Jacquot-SFE/Teensy-synth-platform/research-and-design/proto-8_vanity.jpg

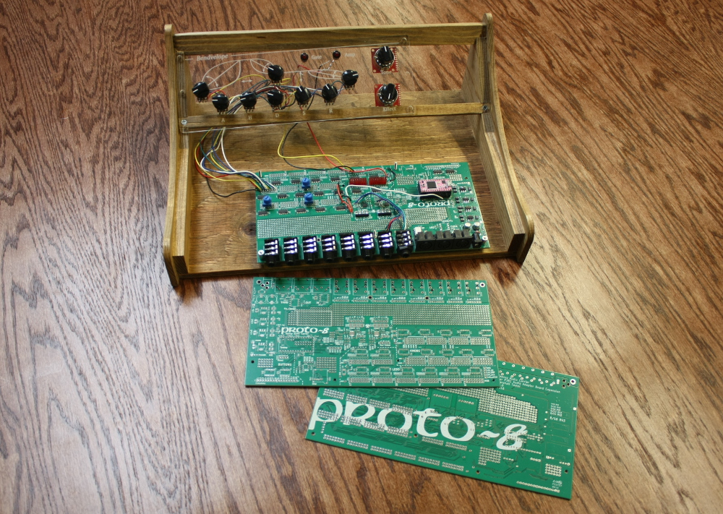
research-and-design/proto-8_vanity.jpg
