Jacquot-SFE/Teensy-synth-platform/presentation/slides/images/arduino.png

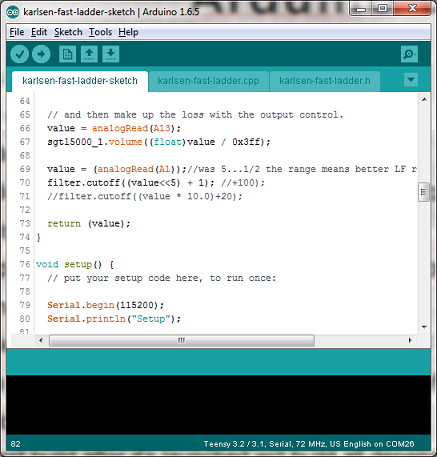
presentation/slides/images/arduino.png
