Jacquot-SFE/Teensy-synth-platform/specs/notes.md

# Notes

**Proposed directory structure**

* documentation -- final documentation of the fully-spec'd product
* hardware -- eagle design files
* libraries -- eagle custom part libraries
* mechanical -- max panel size, possible configurations, case
* research-and-design
 * audio-codec -- codec options and requirements
 * audio-io -- datasheets and audio level driver, buffer calculations, solutions matrix
 * midi -- probably not necessary
 * panel-matrixing -- knob, switch, and LED options
 * power-supply -- requirements, solution matrix, power budget
* specs -- Contains project organization stuff
