Jacquot-SFE/Teensy-synth-platform/research-and-design/power-supply/pmic-options/questionts-to-answer.md

# Questions to answer regarding power supplies

* Do we need a negative supply?
 * Flyback a tapped transformer and regulate from there?
 * Use dual output sepics?
 * Use two single sepics?
* Do we want the circuit to be isolated?
* Do we want integrated fets?
* How much spare current capibility do we provide?

# Questions we've answered (sort of)

* the 5v supply might be on the order of 400mA
