Jacquot-SFE/Teensy-synth-platform/research-and-design/power-supply/power-budget.ods

Knobs
Notes | Current | Multiplier | SubSubtotal
3.3v/10k | 0.00033 | 64 | 0.02112
Mux | 0.00008 | 10 | 0.00080
 |  |  | SubTotal: | 0.022
Switches
Notes | Current | Multiplier | SubSubtotal
3.3v/10k | 0.00033 | 64 | 0.02112
 |  |  | SubTotal: | 0.021
LEDs
Notes | Current | Multiplier | SubSubtotal
LED bias | 0.00200 | 64 | 0.12800
 |  |  | SubTotal: | 0.128
Teensy
Notes | Current | Multiplier | SubSubtotal
Max 150 | 0.15000 | 1 | 0.15000
 |  |  | SubTotal: | 0.150
Midi
Notes | Current | Multiplier | SubSubtotal
2 loops | 0.00500 | 2 | 0.01000
 |  |  | SubTotal: | 0.010
Midi
Notes | Current | Multiplier | SubSubtotal
4 shorted outs | 0.00500 | 4 | 0.02000
 |  |  | SubTotal: | 0.020
 |  |  | Grand Total: | 0.351 | Amps
