Jacquot-SFE/Teensy-synth-platform/presentation/slides/images/bkdrp.JPG

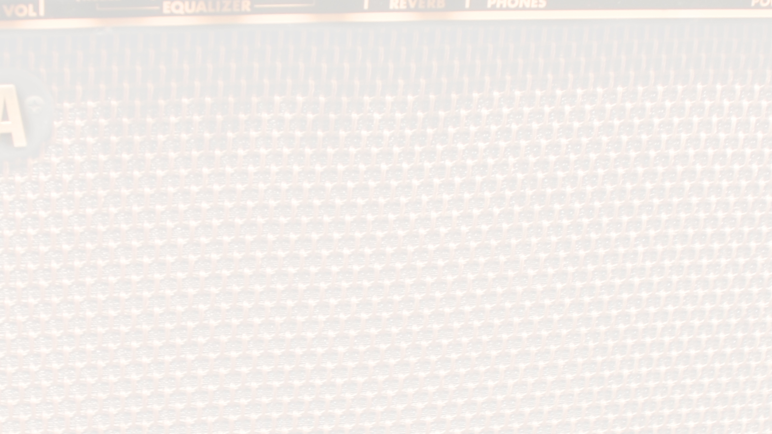
presentation/slides/images/bkdrp.JPG
