Jacquot-SFE/Teensy-synth-platform/presentation/slides/images/notedoor.jpg

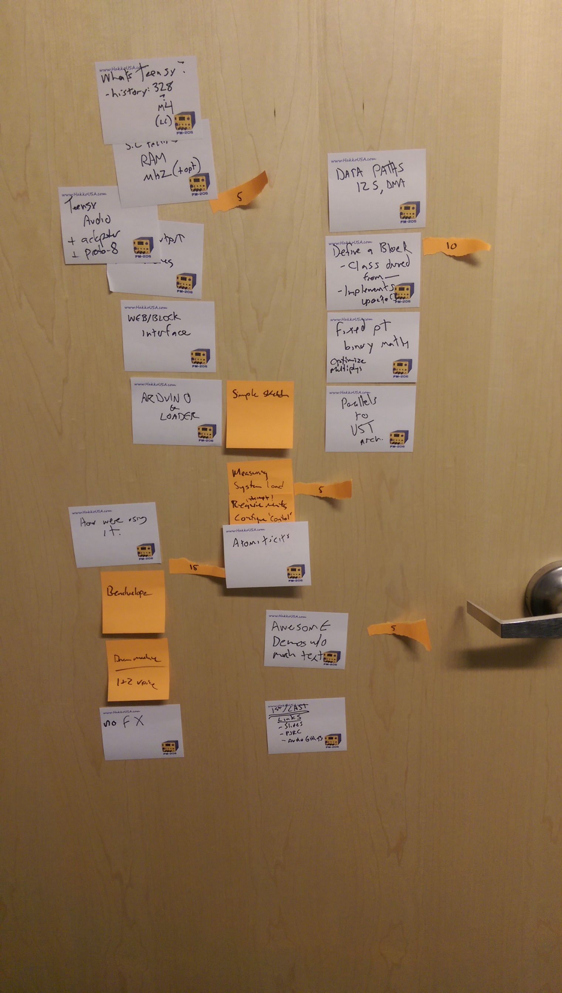
presentation/slides/images/notedoor.jpg
