Jacquot-SFE/Teensy-synth-platform/research-and-design/power-supply/pmic-options/pmic-options.ods

Manufacturer | Part number | Vin | Price | Notes
TI | tl5001a-q1 | 3.6 to 40 | $0.85 @ 1000 | External switch, boost, buck, invert
TI | lm25011 | 6 to 42 | $0.95 @ 1000 | Buck only, 2A, stepoko
TI | sg2524 | 8 to 40 | $0.36 @ 1000 | Multipurpose, flyback, super cheap
LT | LT8471 | 6 to 50 | $5.00 @ 2500 | Dual output 2A, integrated switches, probably wrong pricing
LT | LT8582 | 5 to 22 | $5.00 @ 2500 | Dual output 2A, integrated switches, probably wrong pricing
Maxim | MAX13256 | 36V | $3.00 @ 2500 | No regulation, pumps transformer with H bridge
ST | UC284XB/UC384XB | 30V | $0.25 to $0.60 | UVLO from 8.5 to 16 by part no. Totem output for NMOS drive
