Jacquot-SFE/Teensy-synth-platform/research-and-design/panel-matrixing/analog-mux-options.ods

Sheet: Matrixing options
Desire 64 knobs |  |  |  |  |  |  | Uses 3k quantity pricing from digikey
Mux depth | Level 0 | Level 1 | Level 2 | Level 3 | Ain consumed | Muxes used | Price/mux | total
2 | 32 | 16 | 8 | 4 | 4 | 60 | $0.30 | $18.00
4 | 16 | 4 |  |  | 4 | 20 | $0.23 | $4.60
8 | 8 | 1 |  |  | 1 | 9 | $0.63 | $5.67
16 | 4 |  |  |  | 4 | 4 | $3.50 | $14.00
32 | 2 |  |  |  | 2 | 2 | $4.30 | $8.60
64 | 1 |  |  |  | 1 | 1
M74HC4052RM13TR |  | Part 11141 | $0.09
 | Price | Quantity | Sub
M74HC4052RM13TR | $0.09 | 10 | $0.90
 |  |  | $0.90

Sheet: 2x8x2x2
CTRL |  |  |  | Analog inputs
Level 0 |  | Level 1 |  | A0 | A1 | A2 | A3
0 | 0 | 0 | 0 | K00 | K16 | K32 | K48
0 | 1 | 0 | 0 | K01 | K17 | K33 | K49
1 | 0 | 0 | 0 | K02 | K18 | K34 | K50
1 | 1 | 0 | 0 | K03 | K19 | K35 | K51
0 | 0 | 0 | 1 | K04 | K20 | K36 | K52
0 | 1 | 0 | 1 | K05 | K21 | K37 | K53
1 | 0 | 0 | 1 | K06 | K22 | K38 | K54
1 | 1 | 0 | 1 | K07 | K23 | K39 | K55
0 | 0 | 1 | 0 | K08 | K24 | K40 | K56
0 | 1 | 1 | 0 | K09 | K25 | K41 | K57
1 | 0 | 1 | 0 | K10 | K26 | K42 | K58
1 | 1 | 1 | 0 | K11 | K27 | K43 | K59
0 | 0 | 1 | 1 | K12 | K28 | K44 | K60
0 | 1 | 1 | 1 | K13 | K29 | K45 | K61
1 | 0 | 1 | 1 | K14 | K30 | K46 | K62
1 | 1 | 1 | 1 | K15 | K31 | K47 | K63

Sheet: decode-summer
Comment
 | Price | Quantity | Sub
LM358 | $0.08 | 4 | $0.32
Res | $0.01 | 80 | $0.80
BJT | $0.01 | 16 | $0.16
 |  |  | $1.28

Sheet: Control
Bank Select | Pole Select | A0 | A1 | A2 | A3
0x0 | 0x0 | K00 | K16 | K32 | K48
0x0 | 0x1 | K01 | K17 | K33 | K49
0x0 | 0x2 | K02 | K18 | K34 | K50
0x0 | 0x3 | K03 | K19 | K35 | K51
0x1 | 0x0 | K04 | K20 | K36 | K52
0x1 | 0x1 | K05 | K21 | K37 | K53
0x1 | 0x2 | K06 | K22 | K38 | K54
0x1 | 0x3 | K07 | K23 | K39 | K55
0x2 | 0x0 | K08 | K24 | K40 | K56
0x2 | 0x1 | K09 | K25 | K41 | K57
0x2 | 0x2 | K10 | K26 | K42 | K58
0x2 | 0x3 | K11 | K27 | K43 | K59
0x3 | 0x0 | K12 | K28 | K44 | K60
0x3 | 0x1 | K13 | K29 | K45 | K61
0x3 | 0x2 | K14 | K30 | K46 | K62
0x3 | 0x3 | K15 | K31 | K47 | K63
