Jacquot-SFE/Teensy-synth-platform/(list of files, cad)

Other CAD files:
milling/CheekyElevations/CheekyElevations.FCStd
milling/OpenFacedCheeks/OpenFacedCheeks.FCStd
