Jacquot-SFE/Teensy-synth-platform/research-and-design/power-supply/coil-simulations/flyback.asc

C1: cap; 10µF
C2: cap; 0.001µF
D1: diode
L1: ind2; 10µ
L2: ind2; 10µ
M1: nmos; BSC12DN20NS3
R1: res; 100
R2: res; 1k
R3: res; 1k
R4: res; 1Meg
U2: LT1720
V1: voltage; PULSE(0 5 0 3.99u 0.01u 0 0 1000)
V2: voltage; 15
V3: voltage; 5
V4: voltage; 0
Named nets: 0
.tran 0 .001 0 100n
K L1 L2 1
.lib opamp.sub
