Jacquot-SFE/Teensy-synth-platform/research-and-design/power-supply/coil-simulations/basic-xfmr.asc

L1: ind2; 10µ
L2: ind2; 10µ
M1: nmos; BSC12DN20NS3
R1: res; 50
V1: voltage; PULSE(0 5 .000004 0 0 .000001 .000004 40)
V2: voltage; 15
Named nets: 0
.tran .0002
K L1 L2 1
