Jacquot-SFE/Teensy-synth-platform/research-and-design/power-supply/coil-simulations/LTC1871_sepic.asc

C1: cap; 6800p
C2: cap; 50p
C3: polcap; 4.7µ; Rser=0.05
C4: cap; 33µ; Rser=0.002
C5: cap; 10µ; Rser=0.002
C6: polcap; 150µ; Rser=.01
C7: cap; 10µ; Rser=0.002
D1: schottky; MBR735
I1: load2; 2A; load
L1: ind2; 4.6µ; Rser=0.010
L2: ind2; 4.6µ; Rser=0.010
Q1: NMOS; Si4840DY
R1: RES; 80.6K
R2: res; 12.4K
R3: res; 110K
R4: res; 33.2K
R5: res; 133K
R6: res; 274K
U1: LTC1871
V1: VOLTAGE; 15
Named nets: 0, IN, OUT
K1 L1 L2 1
.tran 1m startup
LTC1871 - 2A SEPIC DC/DC Converter
Input: 5V-15V  Output: 12V@2A
Note:
  If the simulation model is not found please update with the "Sync Release" command from the "Tools" menu.
  It remains the customer's responsibility to verify proper and reliable operation in the actual application.
  Component substitution and printed circuit board layout may significantly affect circuit performance or reliability
  Contact your local sales representative for assistance. This circuit is distributed to customers only for use with LTC parts
  Copyright © 2006 Linear Technology Inc. All rights reserved.
