Jacquot-SFE/Teensy-synth-platform/research-and-design/power-supply/in-rush-limiter/simulation.asc

C1: cap; 1000µF
C2: cap; 4.7µF
D1: diode
M1: pmos; FDS6575
R1: res; 33
R2: res; 1MEG
R3: res; 500k
R4: res; 100
V1: voltage; PULSE(0 12 .01 0.000001 0.000001 .4 1 2)
Named nets: 0
Bulk
Load
.tran 1
