Jacquot-SFE/Teensy-synth-platform/hardware/teensy-boom-jr/teensy-boom-jr.brd

## EAGLE design hardware/teensy-boom-jr/teensy-boom-jr.brd (2016-02-10)

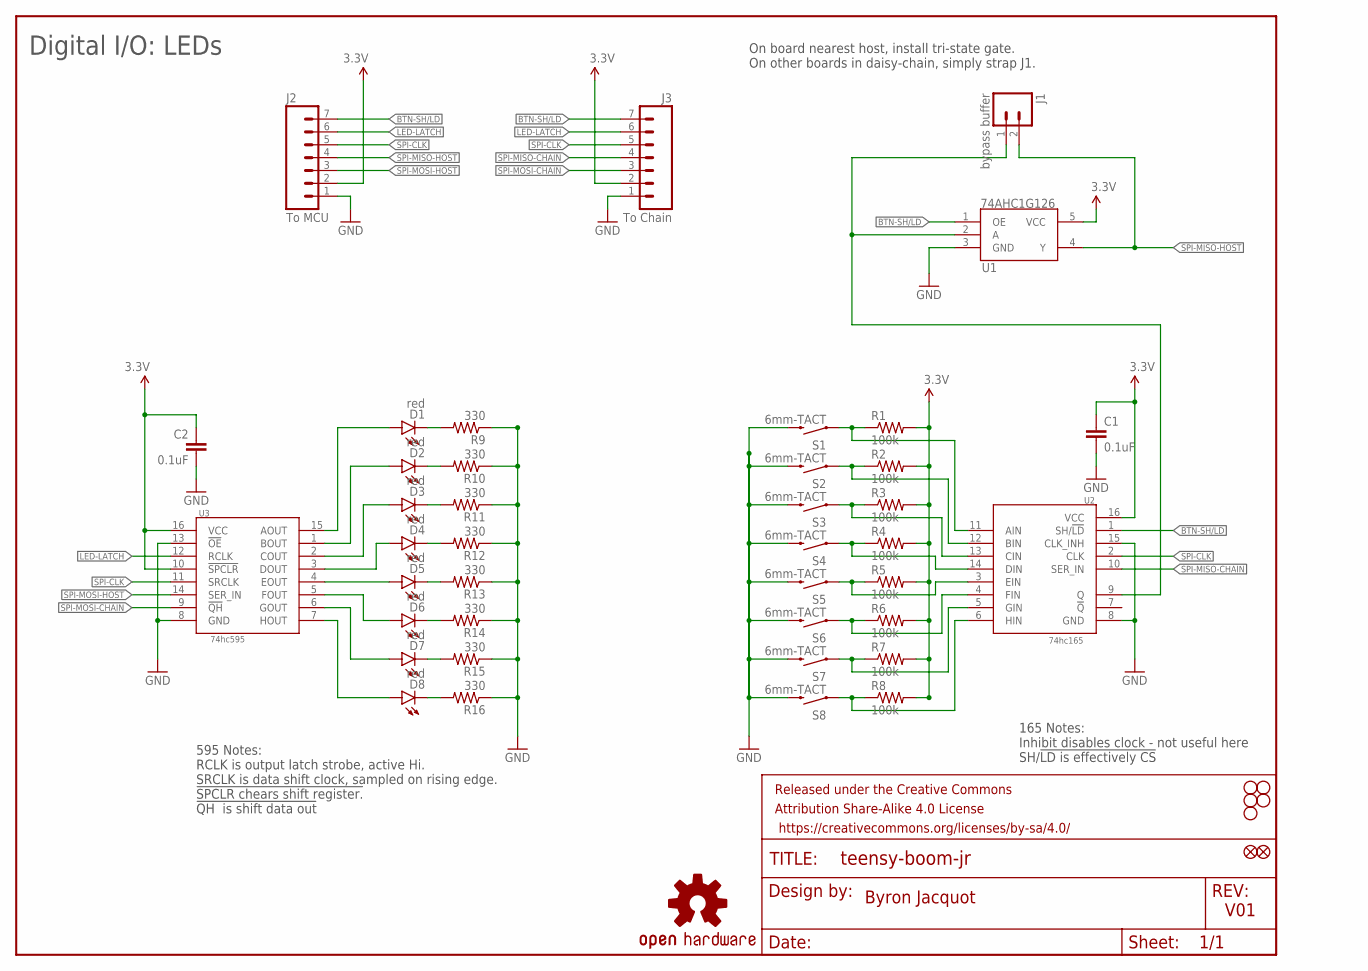
[picture p27: schematic teensy-boom-jr.sch]

Parts:
C1, C2: 0.1uF; 0603-CAP
D1, D2, D3, D4, D5, D6, D7, D8: red; LED3MM-NS
FD1, FD2: FIDUCIALUFIDUCIAL; MICRO-FIDUCIAL
FRAME1: FRAME-LETTER; CREATIVE_COMMONS
H1, H2, H3, H4, H5: STAND-OFF
J1: bypass buffer; 1X02_NO_SILK
J2: To MCU; 1X07_NO_SILK
J3: To Chain; 1X07_NO_SILK
LOGO1: OSHW-LOGOS; OSHW-LOGO-S
R1, R2, R3, R4, R5, R6, R7, R8: 100k; 0805
R9, R10, R11, R12, R13, R14, R15, R16: 330; 0603-RES
S1, S2, S3, S4, S5, S6, S7, S8: 6mm-TACT; TACTILE-PTH-12MM
U1: 74AHC1G126; SOT23-5
U2: 74hc165; SO16
U3: 74hc595; SO16

Connections:
3.3V: C1.1, C2.1, J2.2, J3.2, R1.2, R2.2, R3.2, R4.2, R5.2, R6.2, R7.2, R8.2, U1.5 (VCC), U2.16 (VCC), U3.10 (!SPCLR), U3.16 (VCC)
BTN-SH/LD: J2.7, J3.7, U1.1 (OE), U2.1 (SH/!LD)
GND: C1.2, C2.2, J2.1, J3.1, R9.1, R10.1, R11.1, R12.1, R13.1, R14.1, R15.1, R16.1, S1.3 (2), S2.3 (2), S3.3 (2), S4.3 (2), S5.3 (2), S6.3 (2), S7.3 (2), S8.3 (2), U1.3 (GND), U2.8 (GND), U2.15 (CLK_INH), U3.8 (GND), U3.13 (!OE)
LED-LATCH: J2.6, J3.6, U3.12 (RCLK)
unnamed: R1.1, S1.1, U2.11 (AIN)
unnamed: R2.1, S2.1, U2.12 (BIN)
unnamed: R3.1, S3.1, U2.13 (CIN)
unnamed: R4.1, S4.1, U2.14 (DIN)
unnamed: D8.K (C), R16.2
unnamed: R5.1, S5.1, U2.3 (EIN)
unnamed: R6.1, S6.1, U2.4 (FIN)
unnamed: R7.1, S7.1, U2.5 (GIN)
unnamed: D7.K (C), R15.2
unnamed: D6.K (C), R14.2
unnamed: D5.K (C), R13.2
unnamed: D4.K (C), R12.2
unnamed: D3.K (C), R11.2
unnamed: D2.K (C), R10.2
unnamed: D1.K (C), R9.2
unnamed: R8.1, S8.1, U2.6 (HIN)
unnamed: J1.1, U1.2 (A), U2.9 (Q)
unnamed: D4.A, U3.3 (DOUT)
unnamed: D5.A, U3.4 (EOUT)
unnamed: D6.A, U3.5 (FOUT)
unnamed: D7.A, U3.6 (GOUT)
unnamed: D8.A, U3.7 (HOUT)
unnamed: D3.A, U3.2 (COUT)
unnamed: D2.A, U3.1 (BOUT)
unnamed: D1.A, U3.15 (AOUT)
SPI-CLK: J2.5, J3.5, U2.2 (CLK), U3.11 (SRCLK)
SPI-MISO-CHAIN: J3.4, U2.10 (SER_IN)
SPI-MISO-HOST: J1.2, J2.4, U1.4 (Y)
SPI-MOSI-CHAIN: J3.3, U3.9 (!QH)
SPI-MOSI-HOST: J2.3, U3.14 (SER_IN)

Notes on the sheet:
Digital I/O: LEDs
595 Notes: RCLK is output latch strobe, active Hi. SRCLK is data shift clock, sampled on rising edge. !SPCLR chears shift register. !QH is shift data out
On board nearest host, install tri-state gate. On other boards in daisy-chain, simply strap J1.
165 Notes: Inhibit disables clock - not useful here SH/!LD is effectively CS
Byron Jacquot
V01

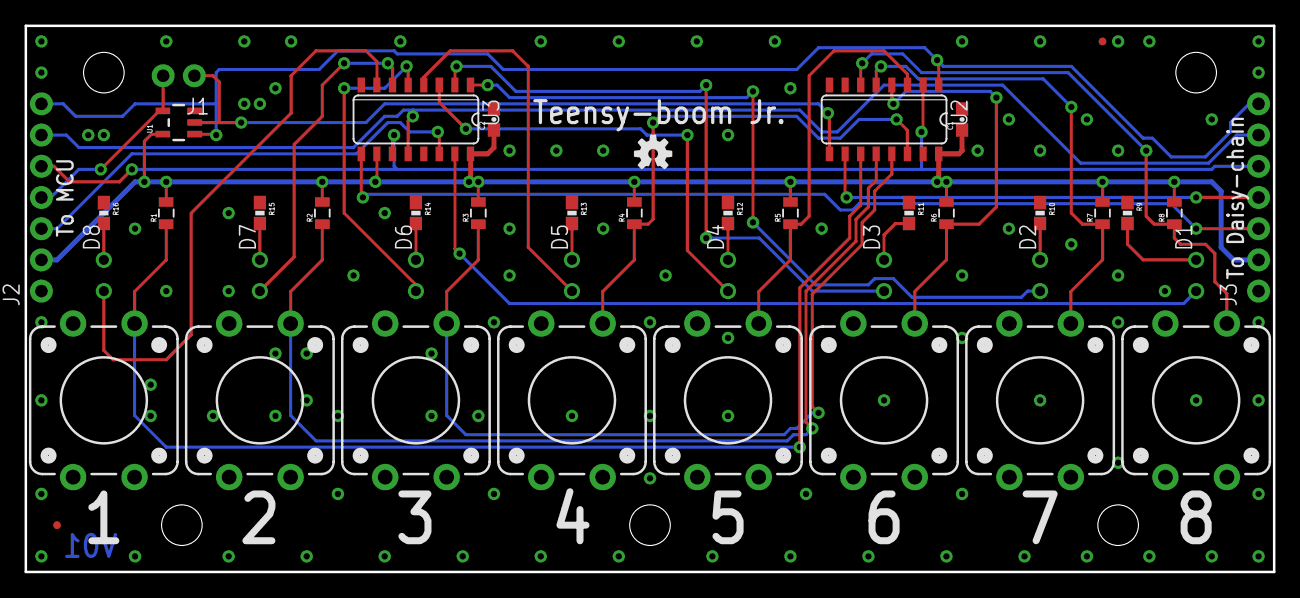
[picture p28: board teensy-boom-jr.brd from above]

Board: 2 copper layers, 101.6 x 44.5 mm, 49 parts (0 on the bottom side), 34 nets.
