Jacquot-SFE/Teensy-synth-platform/hardware/teensy-boom/teensy-boom.brd

## EAGLE design hardware/teensy-boom/teensy-boom.brd (2016-02-08)

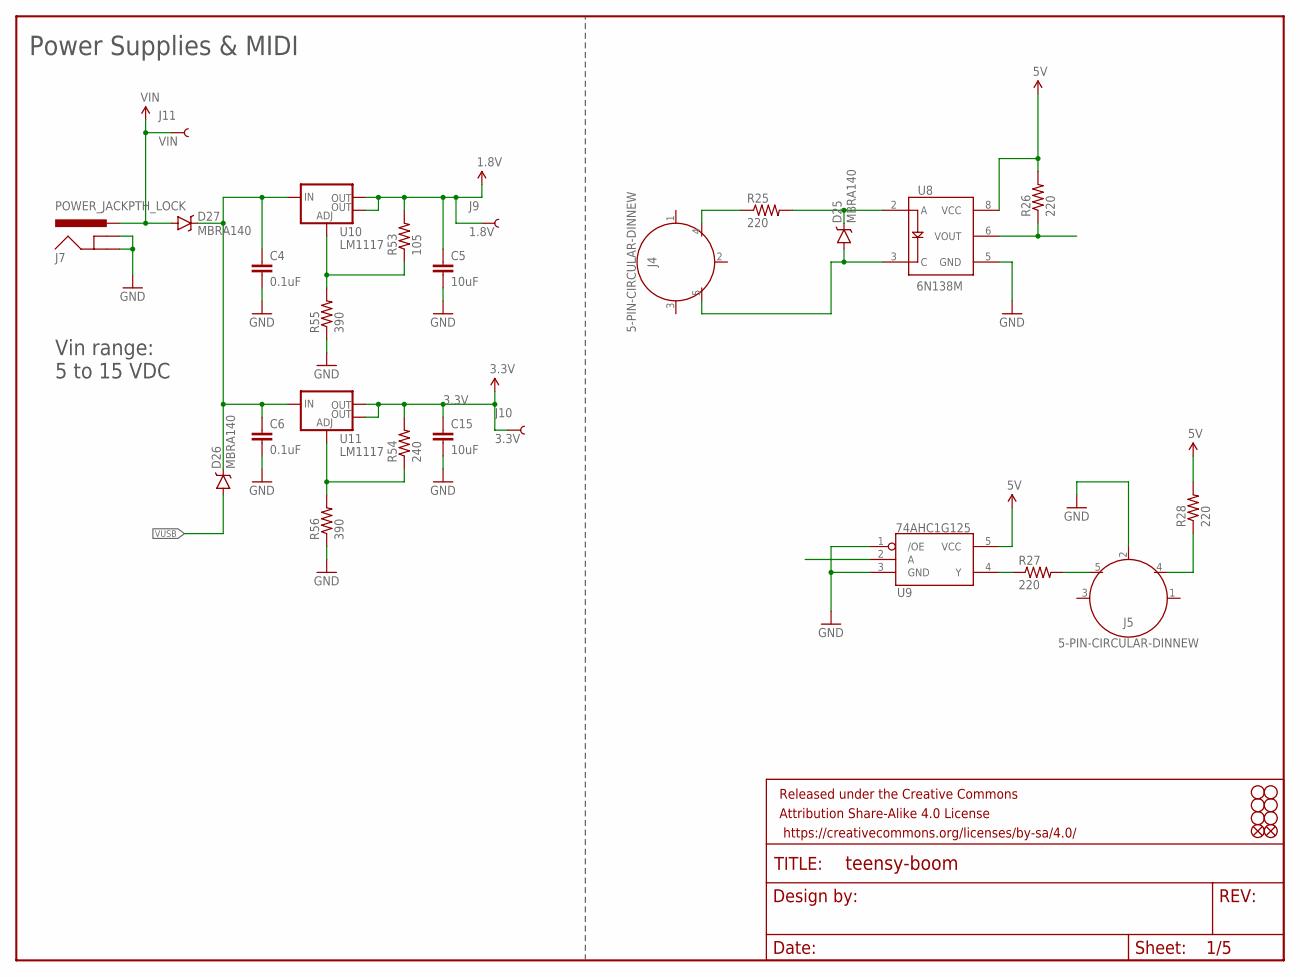
[picture p29: schematic teensy-boom.sch, sheet 1]

Parts:
C4, C6: 0.1uF; 0603-CAP
C5, C15: 10uF; 0603-CAP
D25, D26, D27: MBRA140; SMA-DIODE
FD1, FD2: FIDUCIALUFIDUCIAL; MICRO-FIDUCIAL
FRAME2: FRAME-LETTERNO_PACKAGE; DUMMY
H1, H2, H3, H4, H5, H6: STAND-OFF
J4, J5: 5-PIN-CIRCULAR-DINNEW; 5-PIN-DIN-RA-PCB-NEW
J7: POWER_JACKPTH_LOCK; POWER_JACK_PTH_LOCK
J9: 1.8V; TP_15TH
J10: 3.3V; TP_15TH
J11: VIN; TP_15TH
R25, R26, R27, R28: 220; 0603-RES
R53: 105; 0603-RES
R54: 240; 0603-RES
R55, R56: 390; 0603-RES
U8: 6N138M; 8-SMD
U9: 74AHC1G125; SOT23-5
U10, U11: LM1117; SOT223

Connections:
1.8V: C5.1, J9.P$1, R53.2, U10.2 (OUT), U10.4 (OUT); also elsewhere on the board
3.3V: C15.1, J10.P$1, R54.2, U11.2 (OUT), U11.4 (OUT); also elsewhere on the board
5V: R26.2, R28.2, U8.8 (VCC), U9.5 (VCC)
GND: C4.2, C5.2, C6.2, C15.2, J5.2, J7.GND, J7.GNDBREAK, R55.1, R56.1, U8.5 (GND), U9.1 (/OE), U9.3 (GND); also elsewhere on the board
unnamed: J4.4, R25.1
unnamed: D25.C, R25.2, U8.2 (A)
unnamed: D25.A, J4.5, U8.3 (C)
unnamed: R26.1, U8.6 (VOUT)
unnamed: R27.1, U9.4 (Y)
unnamed: J5.5, R27.2
unnamed: J5.4, R28.1
unnamed: C4.1, C6.1, D26.C, D27.C, U10.3 (IN), U11.3 (IN)
unnamed: R53.1, R55.2, U10.1 (ADJ)
unnamed: R54.1, R56.2, U11.1 (ADJ)
VIN: D27.A, J7.PWR, J11.P$1
VUSB: D26.A; also elsewhere on the board

Notes on the sheet:
Power Supplies & MIDI
Vin range: 5 to 15 VDC

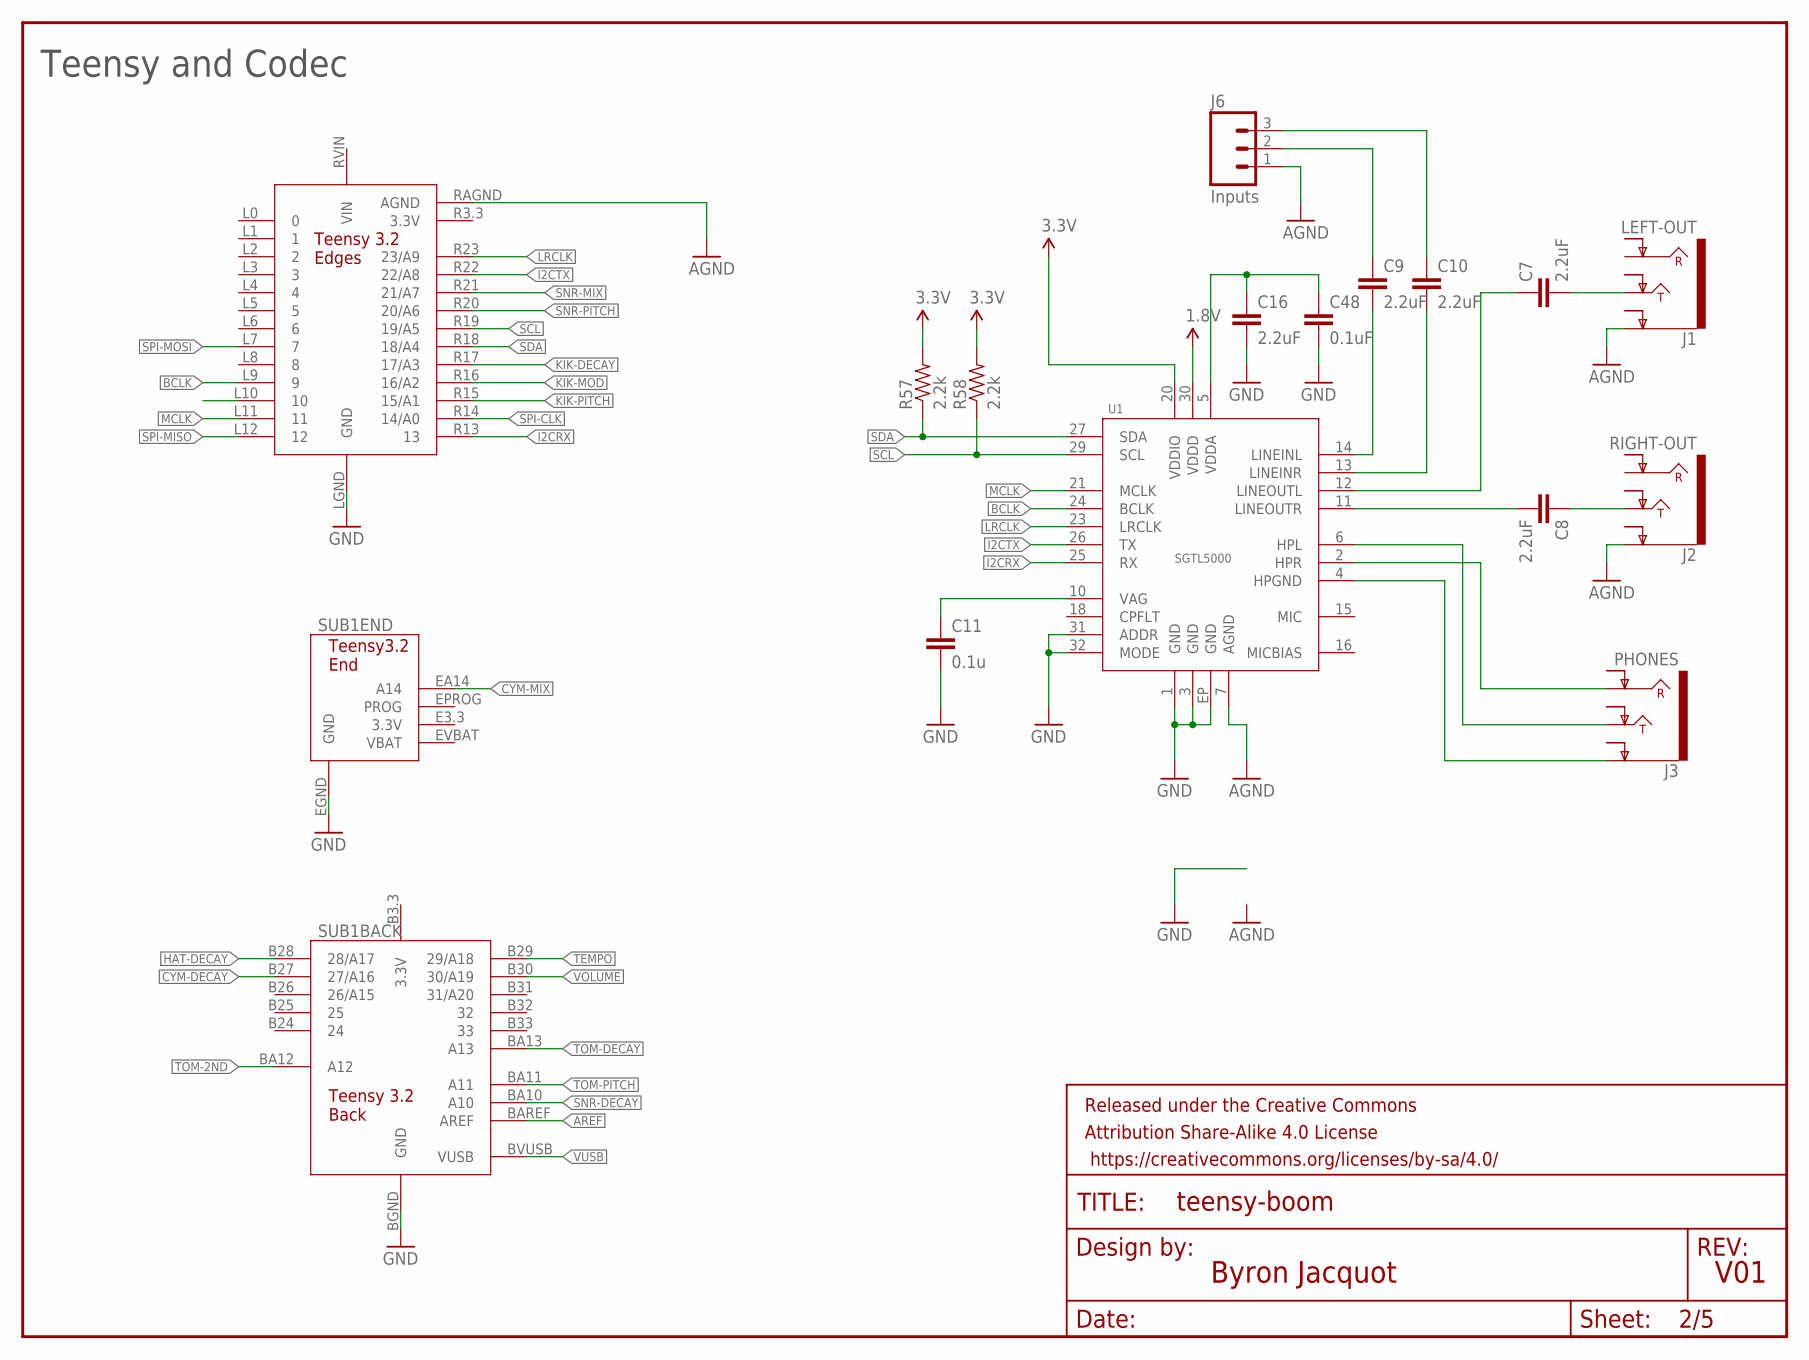
[picture p30: schematic teensy-boom.sch, sheet 2]

Parts:
C7, C8, C9, C10, C16: 2.2uF; 0805-CAP
C11: 0.1u; 0805
C48: 0.1uF; 0603-CAP
FRAME1: FRAME-LETTER; CREATIVE_COMMONS
J1: LEFT-OUT; AUDIO-JACK-.25-INCH-HORIZ-PTH
J2: RIGHT-OUT; AUDIO-JACK-.25-INCH-HORIZ-PTH
J3: PHONES; AUDIO-JACK-.25-INCH-HORIZ-PTH
J6: Inputs; 1X03_LOCK
R57, R58: 2.2k; 0603-RES
SUB1: TEENSY-3.2PTH; TEENSY-3.2
U1: SGTL5000; QFN-32

Connections:
1.8V: U1.30 (VDDD); also elsewhere on the board
3.3V: R57.2, R58.2, U1.20 (VDDIO); also elsewhere on the board
AGND: J1.SLEEVE (EARTH), J2.SLEEVE (EARTH), J6.1, SUB1.RAGND (AGND), U1.7 (AGND); also elsewhere on the board
AREF: SUB1.BAREF (AREF); also elsewhere on the board
BCLK: SUB1.L9 (9), U1.24 (BCLK)
CYM-DECAY: SUB1.B27 (27/A16); also elsewhere on the board
CYM-MIX: SUB1.EA14 (A14); also elsewhere on the board
GND: C11.2, C16.2, C48.2, SUB1.BGND (GND), SUB1.EGND (GND), SUB1.LGND (GND), U1.1 (GND), U1.3 (GND), U1.31 (ADDR), U1.32 (MODE), U1.EP (GND); also elsewhere on the board
HAT-DECAY: SUB1.B28 (28/A17); also elsewhere on the board
I2CRX: SUB1.R13 (13), U1.25 (RX)
I2CTX: SUB1.R22 (22/A8), U1.26 (TX)
KIK-DECAY: SUB1.R17 (17/A3); also elsewhere on the board
KIK-MOD: SUB1.R16 (16/A2); also elsewhere on the board
KIK-PITCH: SUB1.R15 (15/A1); also elsewhere on the board
LRCLK: SUB1.R23 (23/A9), U1.23 (LRCLK)
MCLK: SUB1.L11 (11), U1.21 (MCLK)
unnamed: C8.1, J2.TIP
unnamed: C7.2, J1.TIP
unnamed: C8.2, U1.11 (LINEOUTR)
unnamed: C7.1, U1.12 (LINEOUTL)
unnamed: C10.2, U1.13 (LINEINR)
unnamed: C9.2, U1.14 (LINEINL)
unnamed: J3.TIP, U1.6 (HPL)
unnamed: J3.RING, U1.2 (HPR)
unnamed: J3.SLEEVE (EARTH), U1.4 (HPGND)
unnamed: C9.1, J6.2
unnamed: C10.1, J6.3
unnamed: C11.1, U1.10 (VAG)
unnamed: C16.1, C48.1, U1.5 (VDDA)
SCL: R58.1, SUB1.R19 (19/A5), U1.29 (SCL)
SDA: R57.1, SUB1.R18 (18/A4), U1.27 (SDA)
SNR-DECAY: SUB1.BA10 (A10); also elsewhere on the board
SNR-MIX: SUB1.R21 (21/A7); also elsewhere on the board
SNR-PITCH: SUB1.R20 (20/A6); also elsewhere on the board
SPI-CLK: SUB1.R14 (14/A0); also elsewhere on the board
SPI-MISO: SUB1.L12 (12); also elsewhere on the board
SPI-MOSI: SUB1.L7 (7); also elsewhere on the board
TEMPO: SUB1.B29 (29/A18); also elsewhere on the board
TOM-2ND: SUB1.BA12 (A12); also elsewhere on the board
TOM-DECAY: SUB1.BA13 (A13); also elsewhere on the board
TOM-PITCH: SUB1.BA11 (A11); also elsewhere on the board
VOLUME: SUB1.B30 (30/A19); also elsewhere on the board
VUSB: SUB1.BVUSB (VUSB); also elsewhere on the board

Notes on the sheet:
V01
Byron Jacquot
Teensy and Codec

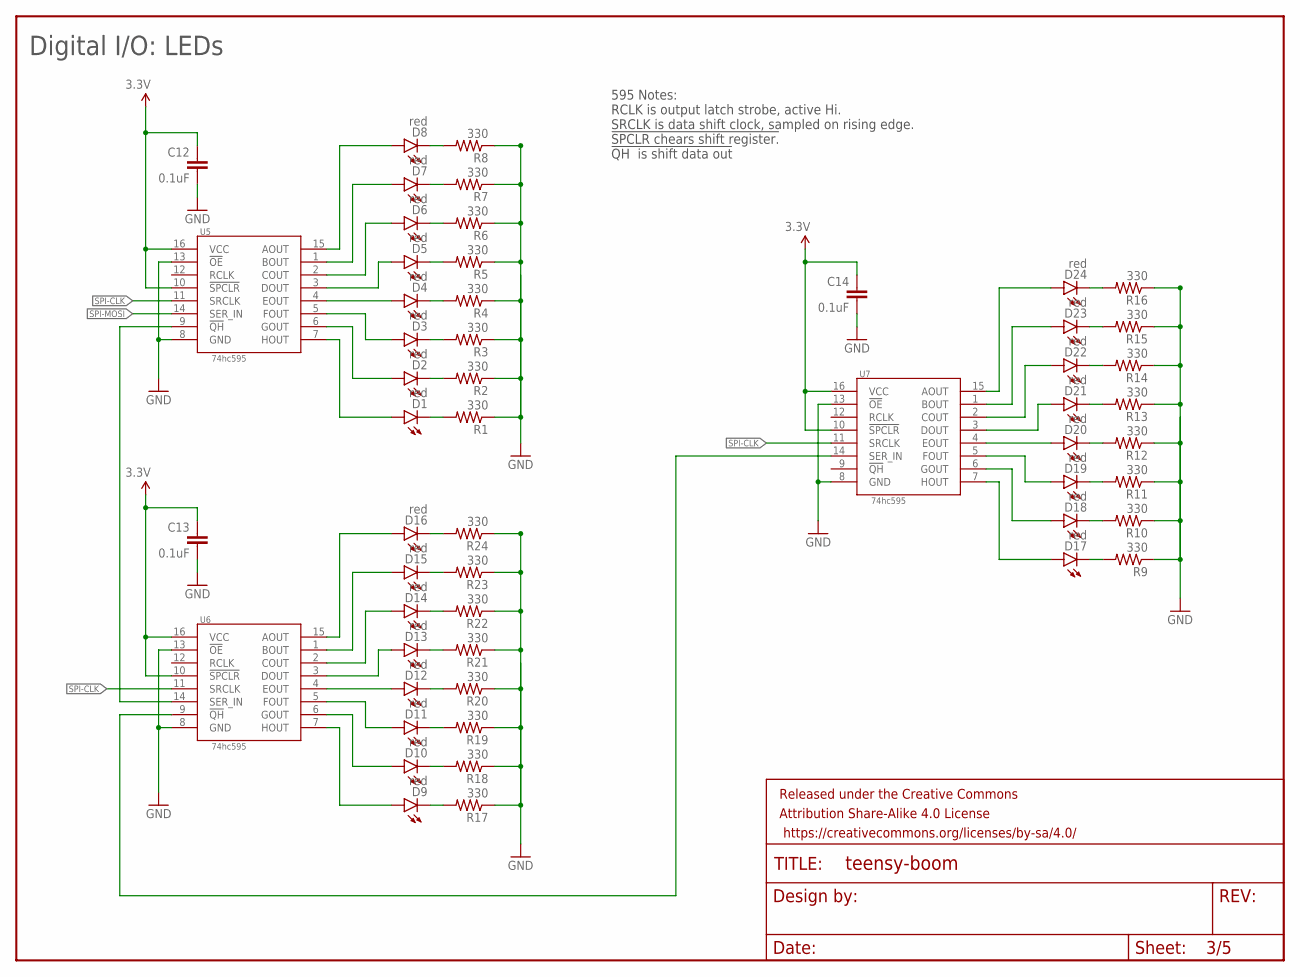
[picture p31: schematic teensy-boom.sch, sheet 3]

Parts:
C12, C13, C14: 0.1uF; 0603-CAP
D1, D2, D3, D4, D5, D6, D7, D8, D9, D10, D11, D12, D13, D14, D15, D16, D17, D18, D19, D20, D21, D22, D23, D24: red; LED3MM-NS
FRAME3: FRAME-LETTERNO_PACKAGE; DUMMY
R1, R2, R3, R4, R5, R6, R7, R8, R9, R10, R11, R12, R13, R14, R15, R16, R17, R18, R19, R20, R21, R22, R23, R24: 330; 0603-RES
U5, U6, U7: 74hc595; SO16

Connections:
3.3V: C12.1, C13.1, C14.1, U5.10 (!SPCLR), U5.16 (VCC), U6.10 (!SPCLR), U6.16 (VCC), U7.10 (!SPCLR), U7.16 (VCC); also elsewhere on the board
GND: C12.2, C13.2, C14.2, R1.1, R2.1, R3.1, R4.1, R5.1, R6.1, R7.1, R8.1, R9.1, R10.1, R11.1, R12.1, R13.1, R14.1, R15.1, R16.1, R17.1, R18.1, R19.1, R20.1, R21.1, R22.1, R23.1, R24.1, U5.8 (GND), U5.13 (!OE), U6.8 (GND), U6.13 (!OE), U7.8 (GND), U7.13 (!OE); also elsewhere on the board
unnamed: D1.K (C), R1.2
unnamed: D2.K (C), R2.2
unnamed: D3.K (C), R3.2
unnamed: D4.K (C), R4.2
unnamed: D5.K (C), R5.2
unnamed: D6.K (C), R6.2
unnamed: D7.K (C), R7.2
unnamed: D8.K (C), R8.2
unnamed: D9.K (C), R17.2
unnamed: D10.K (C), R18.2
unnamed: D11.K (C), R19.2
unnamed: D12.K (C), R20.2
unnamed: D13.K (C), R21.2
unnamed: D14.K (C), R22.2
unnamed: D15.K (C), R23.2
unnamed: D16.K (C), R24.2
unnamed: D17.K (C), R9.2
unnamed: D18.K (C), R10.2
unnamed: D19.K (C), R11.2
unnamed: D20.K (C), R12.2
unnamed: D21.K (C), R13.2
unnamed: D22.K (C), R14.2
unnamed: D23.K (C), R15.2
unnamed: D24.K (C), R16.2
unnamed: D5.A, U5.3 (DOUT)
unnamed: D4.A, U5.4 (EOUT)
unnamed: D3.A, U5.5 (FOUT)
unnamed: D2.A, U5.6 (GOUT)
unnamed: D1.A, U5.7 (HOUT)
unnamed: D6.A, U5.2 (COUT)
unnamed: D7.A, U5.1 (BOUT)
unnamed: D8.A, U5.15 (AOUT)
unnamed: D12.A, U6.4 (EOUT)
unnamed: D11.A, U6.5 (FOUT)
unnamed: D10.A, U6.6 (GOUT)
unnamed: D9.A, U6.7 (HOUT)
unnamed: D13.A, U6.3 (DOUT)
unnamed: D14.A, U6.2 (COUT)
unnamed: D15.A, U6.1 (BOUT)
unnamed: D16.A, U6.15 (AOUT)
unnamed: D20.A, U7.4 (EOUT)
unnamed: D19.A, U7.5 (FOUT)
unnamed: D18.A, U7.6 (GOUT)
unnamed: D17.A, U7.7 (HOUT)
unnamed: D21.A, U7.3 (DOUT)
unnamed: D24.A, U7.15 (AOUT)
unnamed: D23.A, U7.1 (BOUT)
unnamed: D22.A, U7.2 (COUT)
unnamed: U5.9 (!QH), U6.14 (SER_IN)
unnamed: U6.9 (!QH), U7.14 (SER_IN)
SPI-CLK: U5.11 (SRCLK); also elsewhere on the board
SPI-MOSI: U5.14 (SER_IN); also elsewhere on the board

Notes on the sheet:
Digital I/O: LEDs
595 Notes: RCLK is output latch strobe, active Hi. SRCLK is data shift clock, sampled on rising edge. !SPCLR chears shift register. !QH is shift data out

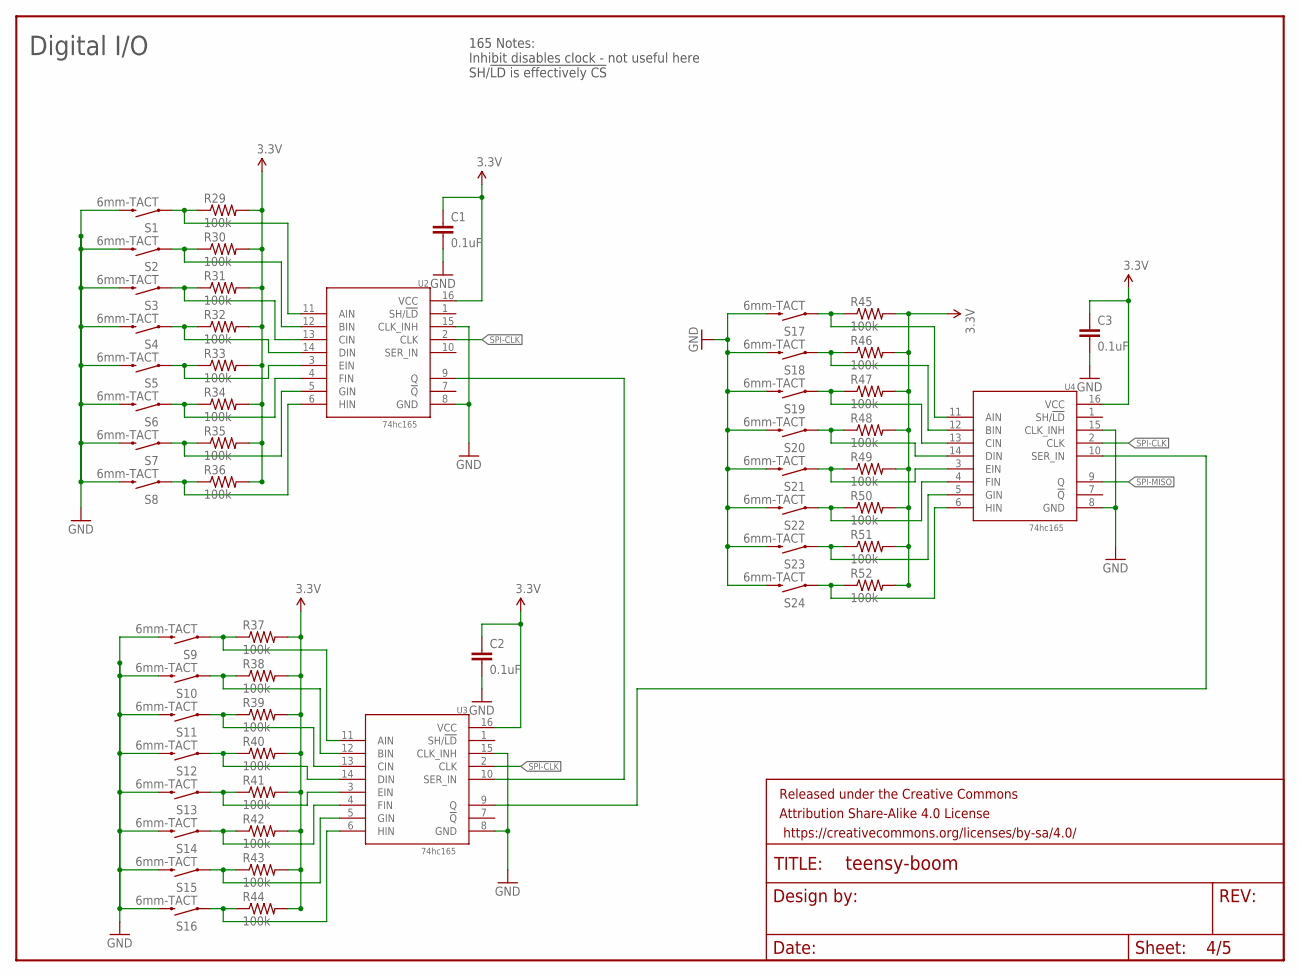
[picture p32: schematic teensy-boom.sch, sheet 4]

Parts:
C1, C2, C3: 0.1uF; 0603-CAP
FRAME5: FRAME-LETTERNO_PACKAGE; DUMMY
R29, R30, R31, R32, R33, R34, R35, R36, R37, R38, R39, R40, R41, R42, R43, R44, R45, R46, R47, R48, R49, R50, R51, R52: 100k; 0805
S1, S2, S3, S4, S5, S6, S7, S8, S9, S10, S11, S12, S13, S14, S15, S16, S17, S18, S19, S20, S21, S22, S23, S24: 6mm-TACT; TACTILE-PTH
U2, U3, U4: 74hc165; SO16

Connections:
3.3V: C1.1, C2.1, C3.1, R29.2, R30.2, R31.2, R32.2, R33.2, R34.2, R35.2, R36.2, R37.2, R38.2, R39.2, R40.2, R41.2, R42.2, R43.2, R44.2, R45.2, R46.2, R47.2, R48.2, R49.2, R50.2, R51.2, R52.2, U2.16 (VCC), U3.16 (VCC), U4.16 (VCC); also elsewhere on the board
GND: C1.2, C2.2, C3.2, S1.3 (2), S2.3 (2), S3.3 (2), S4.3 (2), S5.3 (2), S6.3 (2), S7.3 (2), S8.3 (2), S9.3 (2), S10.3 (2), S11.3 (2), S12.3 (2), S13.3 (2), S14.3 (2), S15.3 (2), S16.3 (2), S17.3 (2), S18.3 (2), S19.3 (2), S20.3 (2), S21.3 (2), S22.3 (2), S23.3 (2), S24.3 (2), U2.8 (GND), U2.15 (CLK_INH), U3.8 (GND), U3.15 (CLK_INH), U4.8 (GND), U4.15 (CLK_INH); also elsewhere on the board
unnamed: R35.1, S7.1, U2.5 (GIN)
unnamed: R29.1, S1.1, U2.11 (AIN)
unnamed: R30.1, S2.1, U2.12 (BIN)
unnamed: R31.1, S3.1, U2.13 (CIN)
unnamed: R32.1, S4.1, U2.14 (DIN)
unnamed: R33.1, S5.1, U2.3 (EIN)
unnamed: R34.1, S6.1, U2.4 (FIN)
unnamed: R36.1, S8.1, U2.6 (HIN)
unnamed: R37.1, S9.1, U3.11 (AIN)
unnamed: R38.1, S10.1, U3.12 (BIN)
unnamed: R39.1, S11.1, U3.13 (CIN)
unnamed: R40.1, S12.1, U3.14 (DIN)
unnamed: R41.1, S13.1, U3.3 (EIN)
unnamed: R42.1, S14.1, U3.4 (FIN)
unnamed: R43.1, S15.1, U3.5 (GIN)
unnamed: R44.1, S16.1, U3.6 (HIN)
unnamed: R45.1, S17.1, U4.11 (AIN)
unnamed: R46.1, S18.1, U4.12 (BIN)
unnamed: R47.1, S19.1, U4.13 (CIN)
unnamed: R48.1, S20.1, U4.14 (DIN)
unnamed: R49.1, S21.1, U4.3 (EIN)
unnamed: R50.1, S22.1, U4.4 (FIN)
unnamed: R51.1, S23.1, U4.5 (GIN)
unnamed: U2.9 (Q), U3.10 (SER_IN)
unnamed: U3.9 (Q), U4.10 (SER_IN)
unnamed: R52.1, S24.1, U4.6 (HIN)
SPI-CLK: U2.2 (CLK); also elsewhere on the board
SPI-MISO: U4.9 (Q); also elsewhere on the board

Notes on the sheet:
Digital I/O
165 Notes: Inhibit disables clock - not useful here SH/!LD is effectively CS

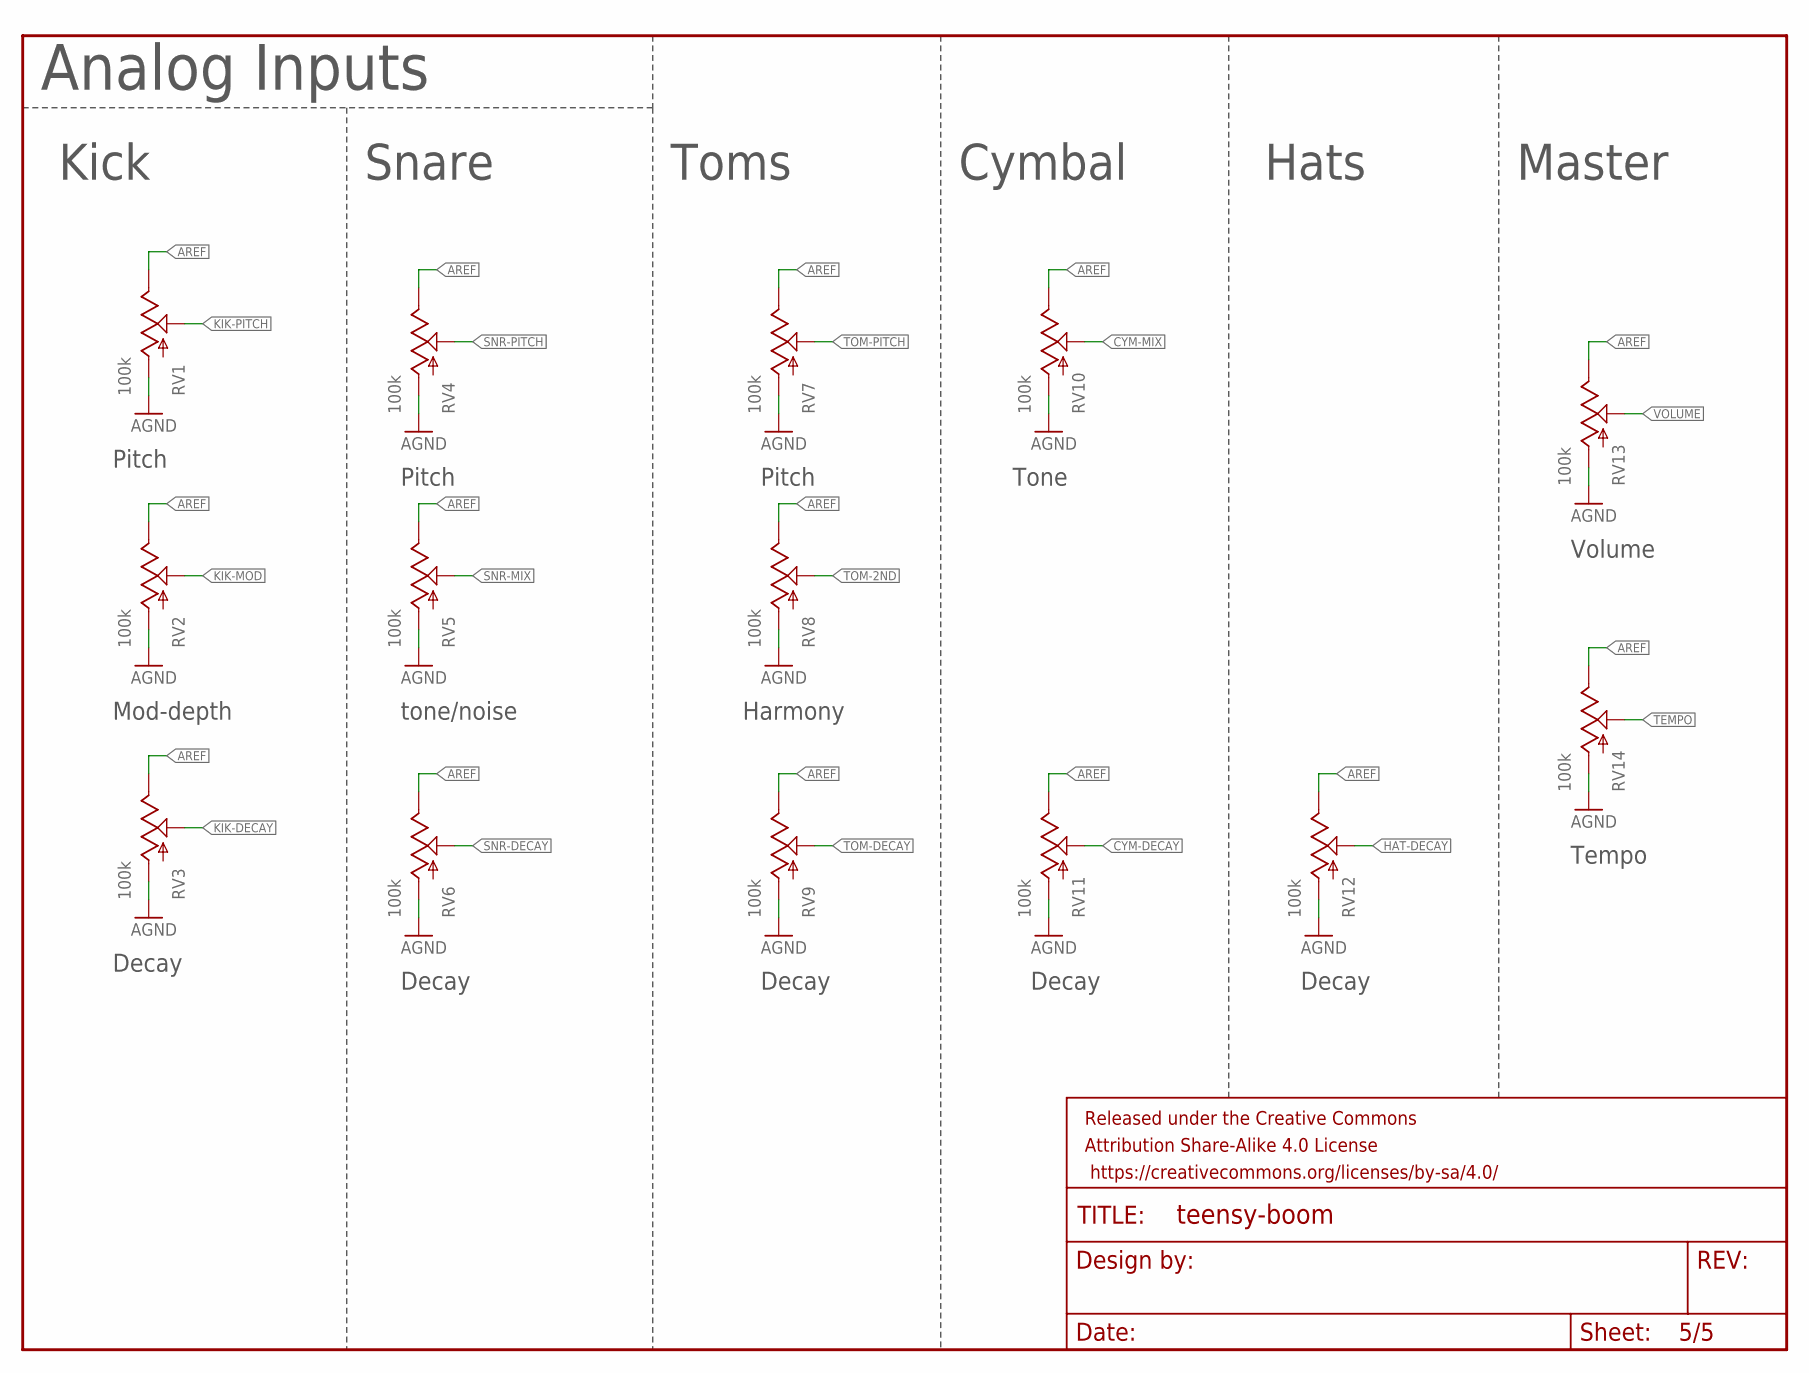
[picture p33: schematic teensy-boom.sch, sheet 5]

Parts:
FRAME4: FRAME-LETTERNO_PACKAGE; DUMMY
RV1, RV2, RV3, RV4, RV5, RV6, RV7, RV8, RV9, RV10, RV11, RV12, RV13, RV14: 100k; ALPS_POT_KIT

Connections:
AGND: RV1.P$3 (A), RV2.P$3 (A), RV3.P$3 (A), RV4.P$3 (A), RV5.P$3 (A), RV6.P$3 (A), RV7.P$3 (A), RV8.P$3 (A), RV9.P$3 (A), RV10.P$3 (A), RV11.P$3 (A), RV12.P$3 (A), RV13.P$3 (A), RV14.P$3 (A); also elsewhere on the board
AREF: RV1.P$1 (E), RV2.P$1 (E), RV3.P$1 (E), RV4.P$1 (E), RV5.P$1 (E), RV6.P$1 (E), RV7.P$1 (E), RV8.P$1 (E), RV9.P$1 (E), RV10.P$1 (E), RV11.P$1 (E), RV12.P$1 (E), RV13.P$1 (E), RV14.P$1 (E); also elsewhere on the board
CYM-DECAY: RV11.P$2 (S); also elsewhere on the board
CYM-MIX: RV10.P$2 (S); also elsewhere on the board
HAT-DECAY: RV12.P$2 (S); also elsewhere on the board
KIK-DECAY: RV3.P$2 (S); also elsewhere on the board
KIK-MOD: RV2.P$2 (S); also elsewhere on the board
KIK-PITCH: RV1.P$2 (S); also elsewhere on the board
SNR-DECAY: RV6.P$2 (S); also elsewhere on the board
SNR-MIX: RV5.P$2 (S); also elsewhere on the board
SNR-PITCH: RV4.P$2 (S); also elsewhere on the board
TEMPO: RV14.P$2 (S); also elsewhere on the board
TOM-2ND: RV8.P$2 (S); also elsewhere on the board
TOM-DECAY: RV9.P$2 (S); also elsewhere on the board
TOM-PITCH: RV7.P$2 (S); also elsewhere on the board
VOLUME: RV13.P$2 (S); also elsewhere on the board

Notes on the sheet:
Analog Inputs
Tempo
Volume
Pitch
Mod-depth
Decay
tone/noise
Harmony
Tone
Kick
Snare
Toms
Cymbal
Hats
Master

Board: 2 copper layers, 175 parts (94 on the bottom side), 131 nets, no tracks yet.
