Jacquot-SFE/Teensy-synth-platform/(commit log)

2015-12-11 added some multiplexing research
    [analog-mux-options.ods]
2015-12-11 did some power supply research
    [pmic-options.ods, power-budget.ods]
2015-12-14 added basic transformer simulation
    [pmic-options.ods]
2015-12-16 Added decode summer to options and topology
    [analog-mux-options.ods]
2015-12-18 updated topology and created kicad project
    [analog-mux-options.ods, muxmatrix.kicad_pcb, muxmatrix.sch]
2015-12-19 worked on layout
    [muxmatrix.kicad_pcb, muxmatrix.sch]
2015-12-28 Adding concept spec for Teensy-boom
2015-12-30 Testing out new dual trimpot footprint
    [muxmatrix.kicad_pcb, muxmatrix.sch]
2016-01-03 removed kicad project
    [muxmatrix.kicad_pcb, muxmatrix.sch]
2016-01-09 Another update to .gitignore, and boom initial files.
    [teensy-boom.brd, teensy-boom.sch]
2016-01-12 More PCB work
    Added knobs, buttons, connectors, MIDI.
    Basic PCB alignment in place...~6"x4"
    [teensy-boom.brd, teensy-boom.sch]
2016-01-19 More work on PCB/Schem
    [teensy-boom.brd, teensy-boom.sch]
2016-01-21 More work on BOOM schem/PCB.
    [teensy-boom.brd, teensy-boom.sch]
2016-01-26 updated docs
    [analog-mux-options.ods]
2016-02-08 Checking in WIP of large Teensy-BOOM board, so I can move to smaller one.
    [teensy-boom.brd, teensy-boom.sch]
2016-02-10 Adding teensy-boom Junior board.
    [teensy-boom-jr.brd, teensy-boom-jr.sch]
2016-02-10 Small updates to get ready to fab.
    [teensy-boom-jr.brd, teensy-boom-jr.sch]
2016-02-21 Added FreeCAD parts for first cheeks
    [CheekyElevations.FCStd, OpenFacedCheeks.FCStd]
2016-02-21 generated toolpaths
    [CheekyElevations.FCStd]
